hellojave/Dummy/Dummy-Robot/4.Model/Motor42-下盖.step

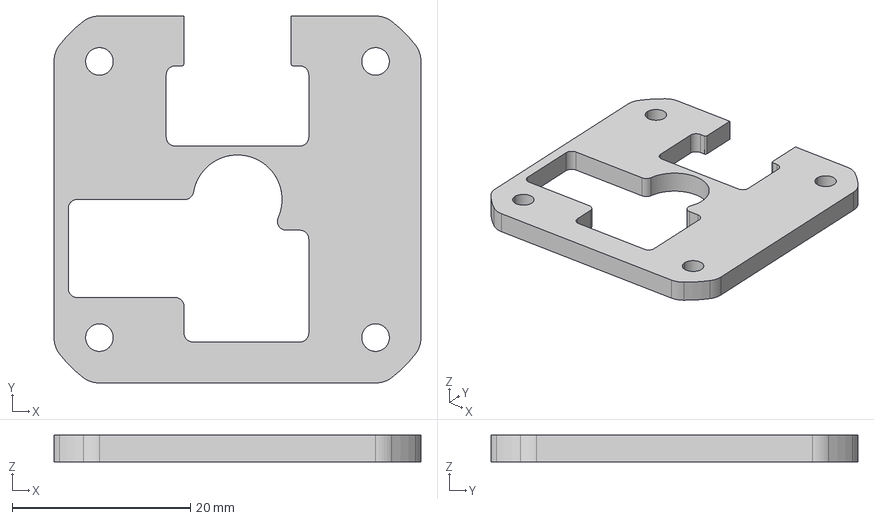
[picture p8: CAD file, 2024-06-04]
Dummy-Robot/4.Model/Motor42-下盖.step
41.2 x 41.2 x 3.00 mm
