hellojave/Dummy/(list of files, drawings)

Other design files:
Dummy-Robot/1.Hardware/Controller/Controller.PcbDoc
Dummy-Robot/1.Hardware/Controller/Controller.PrjPCB
Dummy-Robot/1.Hardware/Controller/Main.SchDoc
Dummy-Robot/1.Hardware/Dangle/Dangle.PcbDoc
Dummy-Robot/1.Hardware/Dangle/Dangle.PrjPCB
Dummy-Robot/1.Hardware/Dangle/Main.SchDoc
Dummy-Robot/1.Hardware/HandModule/HandModule.PrjPCB
Dummy-Robot/1.Hardware/HandModule/Main.SchDoc
Dummy-Robot/1.Hardware/LedRing/LedRing.PcbDoc
Dummy-Robot/1.Hardware/LedRing/LedRing.PrjPCB
Dummy-Robot/1.Hardware/LedRing/Main.SchDoc
Dummy-Robot/1.Hardware/MotorDriver-20/Drive.SchDoc
Dummy-Robot/1.Hardware/MotorDriver-20/Interface.SchDoc
Dummy-Robot/1.Hardware/MotorDriver-20/MCU.SchDoc
Dummy-Robot/1.Hardware/MotorDriver-20/Motor-20.PrjPCB
Dummy-Robot/1.Hardware/MotorDriver-20/Port.SchDoc
Dummy-Robot/1.Hardware/MotorDriver-20/Power.SchDoc
Dummy-Robot/1.Hardware/MotorDriver-42/Drive.SchDoc
Dummy-Robot/1.Hardware/MotorDriver-42/Interface.SchDoc
Dummy-Robot/1.Hardware/MotorDriver-42/MCU.SchDoc
Dummy-Robot/1.Hardware/MotorDriver-42/Motor-42.PrjPCB
Dummy-Robot/1.Hardware/MotorDriver-42/Port.SchDoc
Dummy-Robot/1.Hardware/MotorDriver-42/Power.SchDoc
Dummy-Robot/1.Hardware/MotorDriver-57-unused/Drive.SchDoc
Dummy-Robot/1.Hardware/MotorDriver-57-unused/Interface.SchDoc
Dummy-Robot/1.Hardware/MotorDriver-57-unused/MCU.SchDoc
Dummy-Robot/1.Hardware/MotorDriver-57-unused/Motor-57.PrjPCB
Dummy-Robot/1.Hardware/MotorDriver-57-unused/Port.SchDoc
Dummy-Robot/1.Hardware/MotorDriver-57-unused/Power.SchDoc
Dummy-Robot/1.Hardware/REF/REF-Base/Main.SchDoc
Dummy-Robot/1.Hardware/REF/REF-Base/REF-Base.PrjPCB
Dummy-Robot/1.Hardware/REF/REF-Unit/Main.SchDoc
Dummy-Robot/1.Hardware/REF/REF-Unit/REF-Unit.PrjPCB
