hellojave/Dummy/Dummy-Robot/2.Firmware/Core-STM32F4-fw/REF-STM32F4-fw.ioc

Mcu.UserName=STM32F405RGTx
PA0-WKUP.Signal=UART4_TX
PA1.Signal=UART4_RX
PA10.Signal=USART1_RX
PA11.Signal=USB_OTG_FS_DM
PA12.Signal=USB_OTG_FS_DP
PA13.Signal=SYS_JTMS-SWDIO
PA14.Signal=SYS_JTCK-SWCLK
PA15.Signal=S_TIM2_CH1_ETR
PA2.Signal=S_TIM9_CH1
PA3.Signal=S_TIM9_CH2
PA5.Signal=SPI1_SCK
PA7.Signal=SPI1_MOSI
PA8.Signal=I2C3_SCL
PA9.Signal=USART1_TX
PB10.GPIO_Label=OLED_I2C2_SCL
PB10.Signal=I2C2_SCL
PB11.GPIO_Label=OLED_I2C2_SDA
PB11.Signal=I2C2_SDA
PB12.Signal=CAN2_RX
PB13.Signal=CAN2_TX
PB14.Signal=S_TIM12_CH1
PB15.Signal=S_TIM12_CH2
PB3.Signal=S_TIM2_CH2
PB4.Signal=SPI1_MISO
PB5.Signal=SPI3_MOSI
PB6.GPIO_Label=IMU_I2C1_SCL
PB6.Signal=I2C1_SCL
PB7.GPIO_Label=IMU_I2C1_SDA
PB7.Signal=I2C1_SDA
PB8.Signal=CAN1_RX
PB9.Signal=CAN1_TX
PC10.Signal=SPI3_SCK
PC11.Signal=SPI3_MISO
PC12.Signal=UART5_TX
PC13-ANTI_TAMP.GPIO_Label=KEY
PC13-ANTI_TAMP.Signal=GPIO_Input
PC2.Signal=ADCx_IN12
PC3.Signal=ADCx_IN13
PC4.Signal=ADCx_IN14
PC5.Signal=ADCx_IN15
PC6.Signal=S_TIM3_CH1
PC7.Signal=S_TIM3_CH2
PC8.GPIO_Label=LED
PC8.Signal=GPIO_Output
PC9.Signal=I2C3_SDA
PD2.Signal=UART5_RX
PH0-OSC_IN.Signal=RCC_OSC_IN
PH1-OSC_OUT.Signal=RCC_OSC_OUT
