hellojave/Dummy/Dummy-Robot/2.Firmware/Core-STM32F4-fw/Core/Src/main.c

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
/* Includes ------------------------------------------------------------------*/
#include "main.h"
#include "cmsis_os.h"
#include "adc.h"
#include "can.h"
#include "dma.h"
#include "i2c.h"
#include "spi.h"
#include "tim.h"
#include "usart.h"
#include "usb_device.h"
#include "gpio.h"


/* USER CODE BEGIN PV */
uint64_t serialNumber;
char serialNumberStr[13];
__attribute__((section(".ccmram"))) uint8_t ucHeap[configTOTAL_HEAP_SIZE];
/* USER CODE END PV */

void SystemClock_Config(void);
void MX_FREERTOS_Init(void);
/**
  * @brief  The application entry point.
  * @retval int
  */
int main(void)
{
  /* USER CODE BEGIN 1 */

    // This procedure of building a USB serial number should be identical
    // to the way the STM's built-in USB bootloader does it. This means
    // that the device will have the same serial number in normal and DFU mode.
    uint32_t uuid0 = *(uint32_t *) (UID_BASE + 0);
    uint32_t uuid1 = *(uint32_t *) (UID_BASE + 4);
    uint32_t uuid2 = *(uint32_t *) (UID_BASE + 8);
    uint32_t uuid_mixed_part = uuid0 + uuid2;
    serialNumber = ((uint64_t) uuid_mixed_part << 16) | (uint64_t) (uuid1 >> 16);

    uint64_t val = serialNumber;
    for (size_t i = 0; i < 12; ++i)
    {
        serialNumberStr[i] = "0123456789ABCDEF"[(val >> (48 - 4)) & 0xf];
        val <<= 4;
    }
    serialNumberStr[12] = 0;

  /* USER CODE END 1 */

  /* MCU Configuration--------------------------------------------------------*/

  /* Reset of all peripherals, Initializes the Flash interface and the Systick. */
  HAL_Init();

  /* USER CODE BEGIN Init */
    HAL_RCC_DeInit();

  /* USER CODE END Init */

  /* Configure the system clock */
  SystemClock_Config();

  /* Initialize all configured peripherals */
  MX_GPIO_Init();
  MX_DMA_Init();
  MX_I2C1_Init();
  MX_I2C2_Init();
  MX_CAN1_Init();
  MX_CAN2_Init();
  MX_USART1_UART_Init();
  MX_I2C3_Init();
  MX_SPI1_Init();
  MX_SPI3_Init();
  MX_UART4_Init();
  MX_ADC1_Init();
  MX_UART5_Init();
  MX_TIM2_Init();
  MX_TIM3_Init();
  /* Init scheduler */
  osKernelInitialize();  /* Call init function for freertos objects (in freertos.c) */
  MX_FREERTOS_Init();
  /* Start scheduler */
  osKernelStart();

  /* We should never get here as control is now taken by the scheduler */
  /* Infinite loop */
  /* USER CODE BEGIN WHILE */

    while (1)
    {
    /* USER CODE END WHILE */

    /* USER CODE BEGIN 3 */
    }
  /* USER CODE END 3 */
}

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
/* USER CODE BEGIN 4 */
void OnTimerCallback(TIM_TypeDef *timInstance);
/* USER CODE END 4 */

 /**
  * @brief  Period elapsed callback in non blocking mode
  * @note   This function is called  when TIM6 interrupt took place, inside
  * HAL_TIM_IRQHandler(). It makes a direct call to HAL_IncTick() to increment
  * a global variable "uwTick" used as application time base.
  * @param  htim : TIM handle
  * @retval None
  */
void HAL_TIM_PeriodElapsedCallback(TIM_HandleTypeDef *htim)
{
  if (htim->Instance == TIM6) {
    HAL_IncTick();
  }
  /* USER CODE BEGIN Callback 1 */
  else
  {
      OnTimerCallback(htim->Instance);
  }
  /* USER CODE END Callback 1 */
}

/**
  * @brief  This function is executed in case of error occurrence.
  * @retval None
  */
void Error_Handler(void)
{
  /* USER CODE BEGIN Error_Handler_Debug */
    /* User can add his own implementation to report the HAL error return state */
    __disable_irq();
    while (1)
    {
    }
  /* USER CODE END Error_Handler_Debug */
}

#ifdef  USE_FULL_ASSERT
/**
  * @brief  Reports the name of the source file and the source line number
  *         where the assert_param error has occurred.
  * @param  file: pointer to the source file name
  * @param  line: assert_param error line source number
  * @retval None
  */
void assert_failed(uint8_t *file, uint32_t line)
{
  /* USER CODE BEGIN 6 */
  /* User can add his own implementation to report the file name and line number,
     ex: printf("Wrong parameters value: file %s on line %d\r\n", file, line) */
  /* USER CODE END 6 */
}
#endif /* USE_FULL_ASSERT */

/************************ (C) COPYRIGHT STMicroelectronics *****END OF FILE****/
