hellojave/Dummy/(notices)

Notices in the files:
Dummy-Robot/2.Firmware/Core-STM32F4-fw/Core/Src/main.c:
This software component is licensed by ST under BSD 3-Clause license,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
